DitroniX/IPEM-S3-AI-ESP32-S3-IoT-Ethernet-Mains-Power-Energy-Monitor/Code/Arduino/README.md

** IPEM S3-AI ESP32-S3 IoT Ethernet Mains Power Energy Monitor **

------------

This folder contains Example Source Code.

  The purpose of the test code is to cycle through the various main functions of the board, as shown below, as part of board bring up testing.

  PlatformIO code will automatically load required libraries and configure board.   See platformio.ini for information,

  Remember!  If ESP32-S3 based:
  - Set the BOARD to ESP32-S3 DEV MODULE (or similar).
  - You may set the BAUD rate to 921600 to speed up flashing.
  - The SDK does NOT need external power to flash and will take Power from the USB 5V.
  
  This test code is OPEN SOURCE and formatted for easier viewing.  Although is is not intended for real world use, it may be freely used, or modified as needed.
  It is distributed on an "AS IS" BASIS, WITHOUT WARRANTIES OR CONDITIONS OF ANY KIND, either express or implied.

## **Further Information**

Additional information, and other technical details on this project, maybe found in the related repository pages.

**Repository Folders**

 - **Code** *(Code examples for Arduino  IDE, Raspberry Pi and PlatformIO)*
 -  **Datasheets and Information** *(Component Datasheets, Schematics, Board Layouts, Photos, Technical Documentation)*
 - **Certification** *(Related Repository Project or Part, Certification Information)*

**Repository Tabs**

 - **Wiki** *(Related Repository Wiki pages and Technical User Information)*
 - **Discussions** *(Related Repository User Discussion Forum)*
 - **Issues** *(Related Repository Technical Issues and Fixes)*

***

We value our Customers, Users of our designs and STEM Communities, all over the World . Should you have any other questions, or feedback to share to others, please feel free to:

* Visit the related [Project](https://github.com/DitroniX?tab=repositories) *plus the related* **Discussions** and **Wiki** Pages.  See tab in each separate repository.
* **Project Community Information** can be found at https://www.hackster.io/DitroniX
* [DitroniX.net Website - Contact Us](https://ditronix.net/contact/)
* **Twitter**: [https://twitter.com/DitroniX](https://twitter.com/DitroniX)
* [Supporting the STEM Projects - BuyMeACoffee](https://www.buymeacoffee.com/DitroniX)
*  **LinkedIN**: [https://www.linkedin.com/in/g8puo/](https://www.linkedin.com/in/g8puo/)

***Dave Williams, Maidstone, UK.***

Electronics Engineer | Software Developer | R&D Support | RF Engineering | Product Certification and Testing | STEM Ambassador

## STEM

**Supporting [STEM Learning](https://www.stem.org.uk/)**

Life is one long exciting learning curve, help others by setting the seed to knowledge.
