DitroniX/IPEM-S3-AI-ESP32-S3-IoT-Ethernet-Mains-Power-Energy-Monitor/Certification/ESP32-S3-WROOM-1U SRRC.pdf

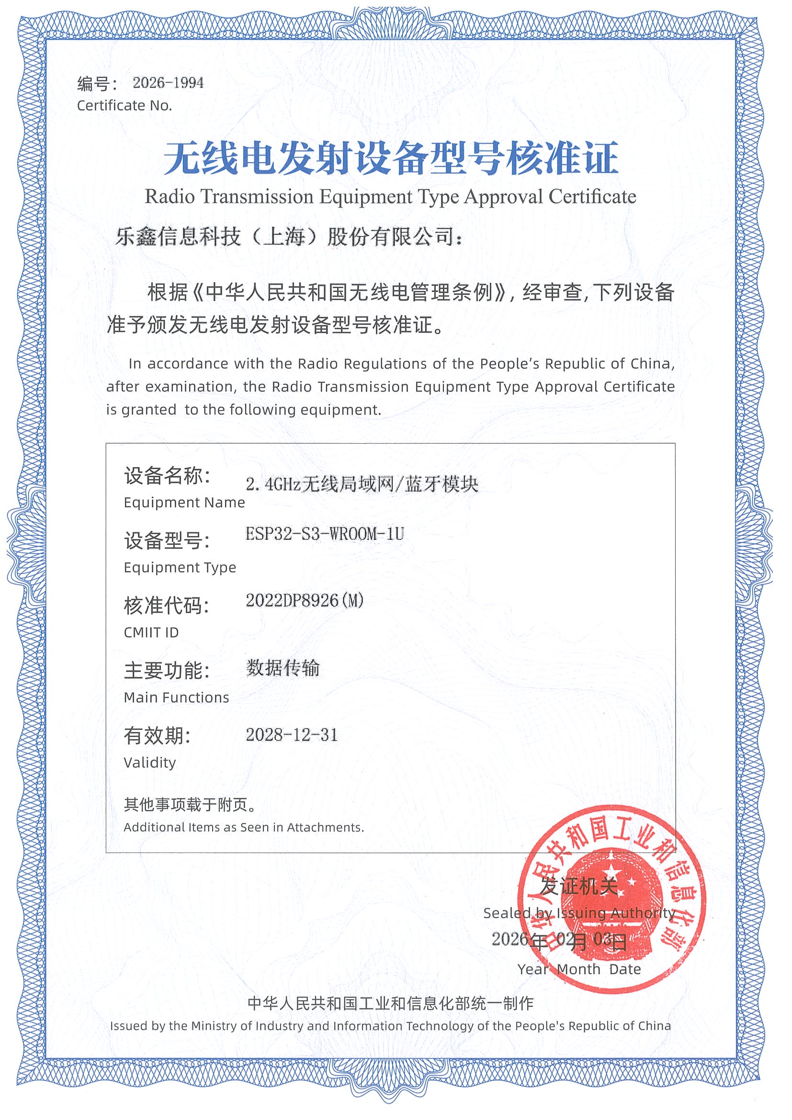
[picture p4: page 1]
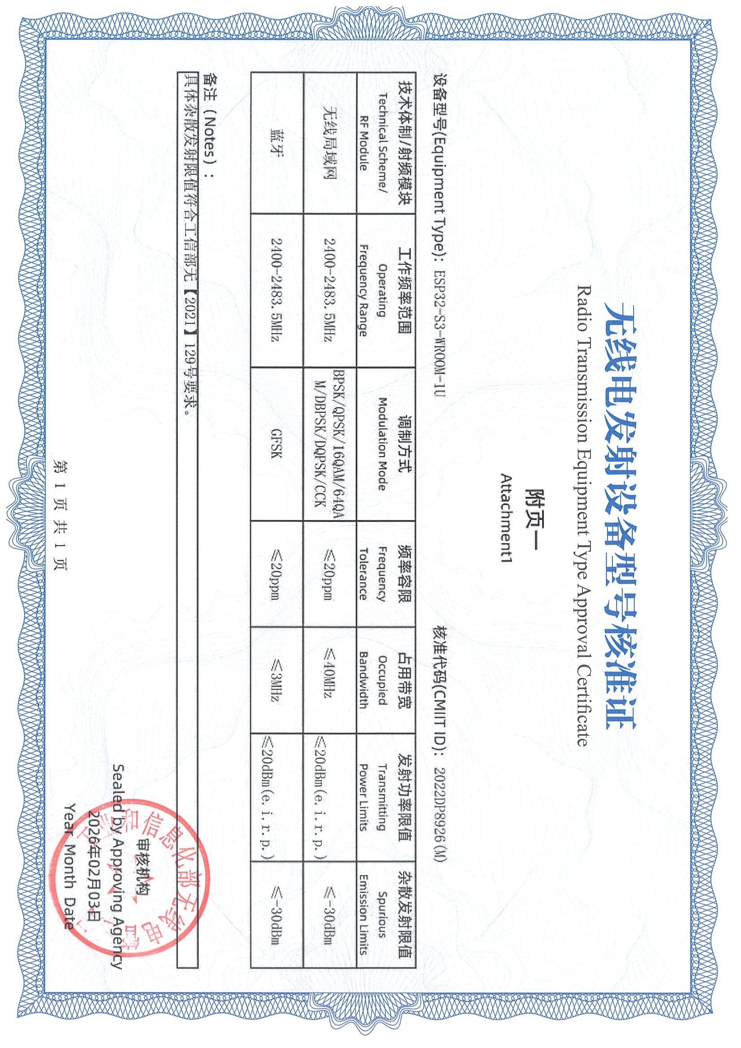
[picture p5: page 2]
