DitroniX/IPEM-S3-AI-ESP32-S3-IoT-Ethernet-Mains-Power-Energy-Monitor/Datasheets and Information/Arduino S3.png

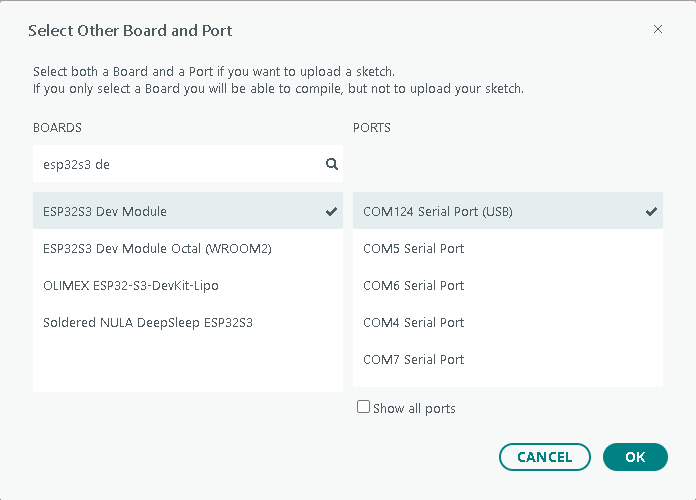
Datasheets and Information/Arduino S3.png
