DitroniX/IPEM-S3-AI-ESP32-S3-IoT-Ethernet-Mains-Power-Energy-Monitor/Datasheets and Information/EPEM S3 AI Pin Matrix - Pin Order.png

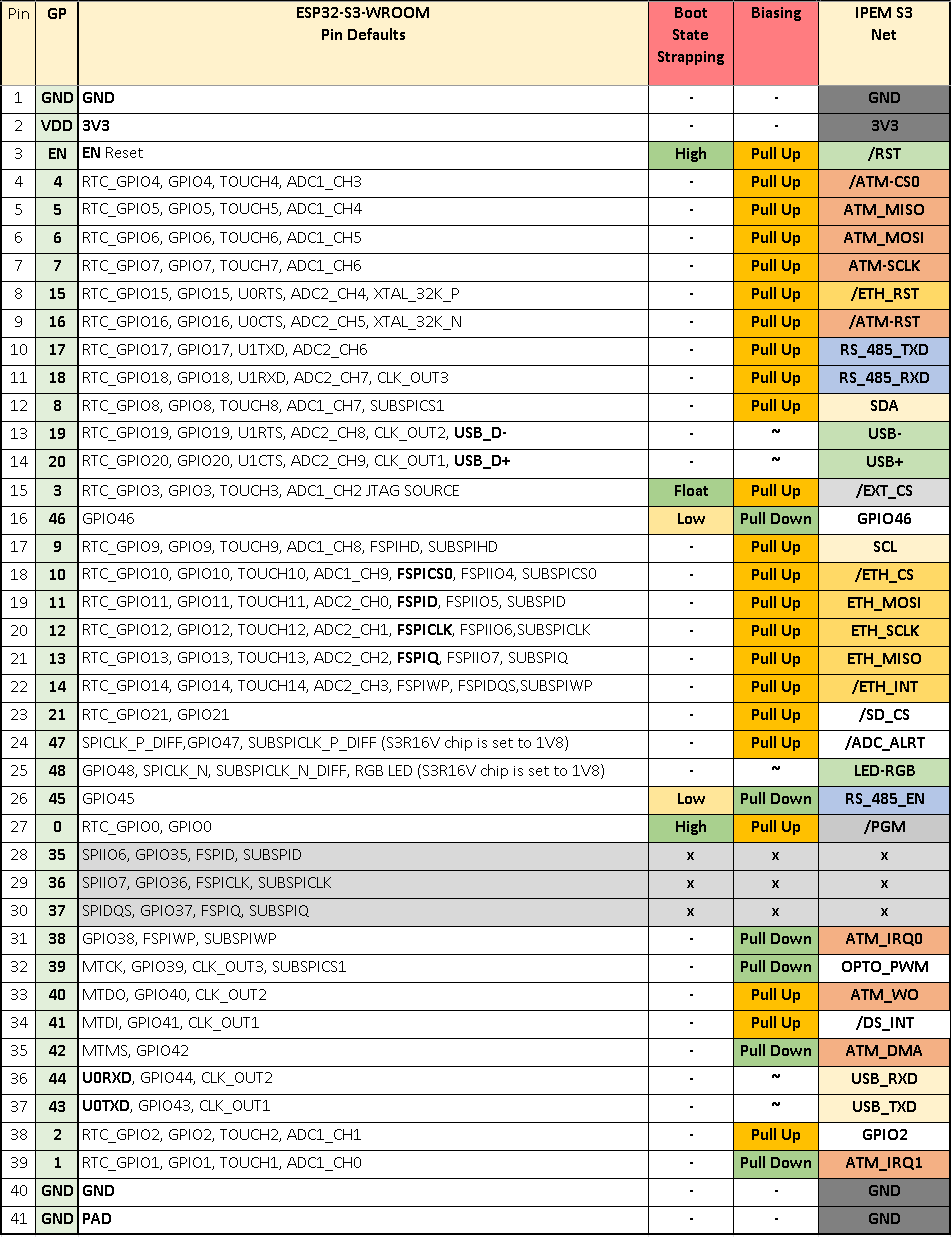
Datasheets and Information/EPEM S3 AI Pin Matrix - Pin Order.png
