DitroniX/IPEM-S3-AI-ESP32-S3-IoT-Ethernet-Mains-Power-Energy-Monitor/Code/PlatformIO/IPEM S3-AI ESP32-S3 Test/Configuration Header Examples.md

**Below are EXAMPLE Configuration Outputs**

Hardware Configuration for ATM90E36 ATM_SPLIT_PHASE
-----------------------------------
AC Voltage Inputs:      Multi Dual V1 and V3 - USA Configuration
Split AC Voltage:       Dual Input V1 + V3 Enabled - USA Configuration
CT Current Clamps:      Phase Configured for 1 and 3 + 1 Phase (I4N)
CT4 Current Input:      Configured for I4N on the ATM90E36

Hardware Configuration for ATM90E36
-----------------------------------
AC Voltage Inputs:      Multi Separated V1 V2 V3 - 3 Phase Configuration.
Split AC Voltage:       Dual Disabled
CT Current Clamps:      Configured for 1, 2, 3 Phase + 1 Phase (I4N)
CT4 Current Input:      Configured for I4N on the ATM90E36

Hardware Configuration for ATM90E36 ATM_SINGLE_PHASE
-----------------------------------
AC Voltage Inputs:      Single Input V1 will be used for all Current Phase Calculations
Split AC Voltage:       Dual Disabled
CT Current Clamps:      Configured for 1, 2, 3 Phase + 1 Phase (I4N)
CT4 Current Input:      Configured for I4N on the ATM90E36
