DitroniX/IPEM-S3-AI-ESP32-S3-IoT-Ethernet-Mains-Power-Energy-Monitor/(commit log)

2026-06-18 New IPEM S3-Ai Board
2026-06-18 ATM90E36 Registers
    [IPEM S3-AI ATM90E36 ATM90E32 Registers.xlsx]
2026-07-29 Create IPEM Plus CT Clamp connected to Consumer Unit Tails.jpg
2026-07-29 IPEM S3-A Clamp connected to Consumer Unit Tails
2026-08-18 IPEM S3-A3 PreProduction Boards
2026-08-18 Create Arduino S3.png
2026-09-30 IPEM S3-AI Pin Matrix
2026-10-30 IPEM S3 AI Pin Matrix for 103
